JonasE99/HCP-Bridge/hardware/fabrication/bom.csv

Qty | References | Value | Footprint | Manufacturer part | LCSC
4 | C3 C6 C8 C9 | 100n | C_0603_1608Metric |  | C14663
1 | C10 | 1u | C_0603_1608Metric |  | C5673
3 | C4 C5 C7 | 22u 25V | C_1206_3216Metric |  | C77091
2 | C1 C2 | 2u2 100V | C_1206_3216Metric |  | C170101
5 | D2 D3 D4 D5 D6 | DSS16 | D_SOD-123 | DSS16 (60 V, 1 A) | C7467023
1 | D8 | SM712 | SOT-23 | Semtech SM712.TCT | C12067
1 | D1 | SMAJ33CA | D_SMA | SMAJ33CA (bidirectional) | C115251
1 | D10 | USBLC6-2SC6 | SOT-23-6 | ST USBLC6-2SC6 | C7519
1 | D9 | blue | LED_0603_1608Metric | KT-0603B | C2288
1 | D7 | green | LED_0603_1608Metric | KT-0603G | C12624
1 | F1 | 200mA | Fuse_1206_3216Metric | BSMD1206-020-48V | C49328459
1 | JP3 | 120R | SolderJumper-2_P1.3mm_Open_RoundedPad1.0x1.5mm
1 | JP1 | A select | SolderJumper-3_P1.3mm_Bridged12_RoundedPad1.0x1.5mm
1 | JP2 | B select | SolderJumper-3_P1.3mm_Bridged12_RoundedPad1.0x1.5mm
1 | J1 | RJ12 HCP bus | RJ12_Molex_95501-2661_Horizontal | Molex 95501-2661 | C240856
1 | J2 | USB-C | USB_C_Receptacle_HRO_TYPE-C-31-M-12 | HRO TYPE-C-31-M-12 | C165948
1 | L1 | 22uH | L_Sunlord_SWPA5040S | Bourns SRN5040TA-220M (Isat 1.62 A) | C2046438
1 | R1 | 100k | R_0603_1608Metric | 0603WAF1003T5E | C25803
2 | R5 R6 | 10R | R_0603_1608Metric |  | C22859
4 | R10 R11 R12 R13 | 10k | R_0603_1608Metric | Yageo RC0603FR-0710KL | C98220
1 | R9 | 120R | R_0603_1608Metric |  | C22787
2 | R4 R14 | 1k | R_0603_1608Metric | 0603WAF1001T5E | C21190
1 | R3 | 22k1 1% | R_0603_1608Metric |  | C137768
2 | R7 R8 | 4k7 | R_0603_1608Metric | 0603WAF4701T5E | C23162
2 | R15 R16 | 5k1 | R_0603_1608Metric | 0603WAF5101T5E | C23186
1 | R2 | 69k8 1% | R_0603_1608Metric |  | C23098
1 | SW2 | BOOT | SW_Push_1P1T_XKB_TS-1187A | XKB TS-1187A-B-A-B | C318884
1 | SW1 | RESET | SW_Push_1P1T_XKB_TS-1187A | XKB TS-1187A-B-A-B | C318884
1 | TP2 | ESP_RXD0 | TestPoint_Pad_D1.5mm
1 | TP1 | ESP_TXD0 | TestPoint_Pad_D1.5mm
1 | TP3 | GND | TestPoint_Pad_D1.5mm
1 | U3 | ESP32-S3-WROOM-1-N8R2 | ESP32-S3-WROOM-1 | Espressif ESP32-S3-WROOM-1-N8R2 | C2913204
1 | U1 | LMR51610XDBVR | SOT-23-6 | TI LMR51610XDBVR | C20539658
1 | U2 | THVD1406DR | SOIC-8_3.9x4.9mm_P1.27mm | TI THVD1406DR | C5215918
