JonasE99/HCP-Bridge/hardware/fabrication/schematic.pdf

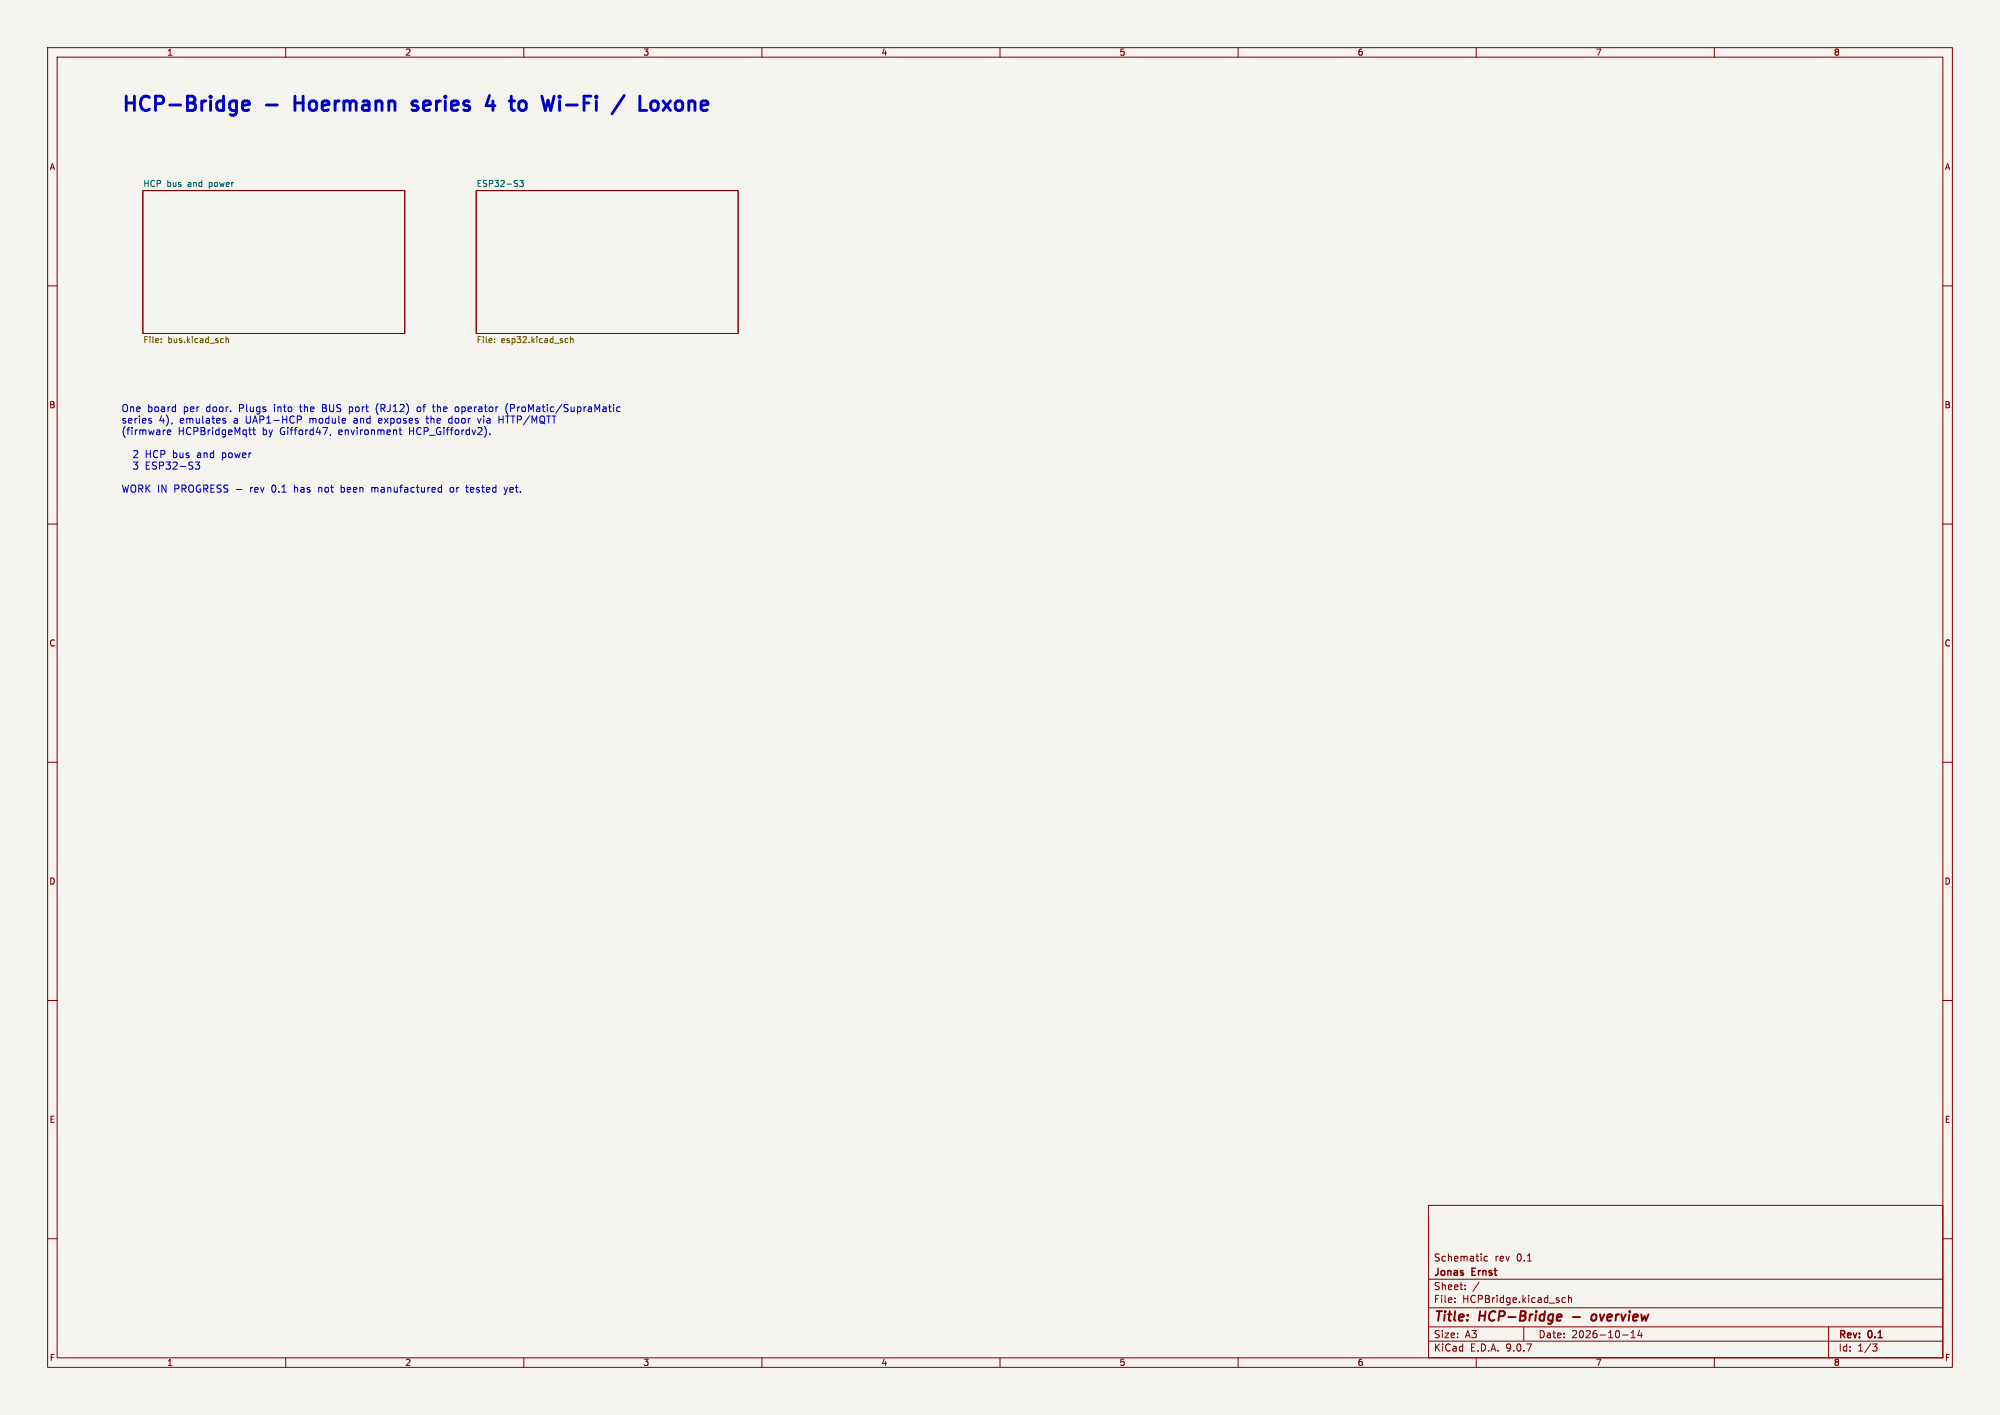
[picture p2: page 1]

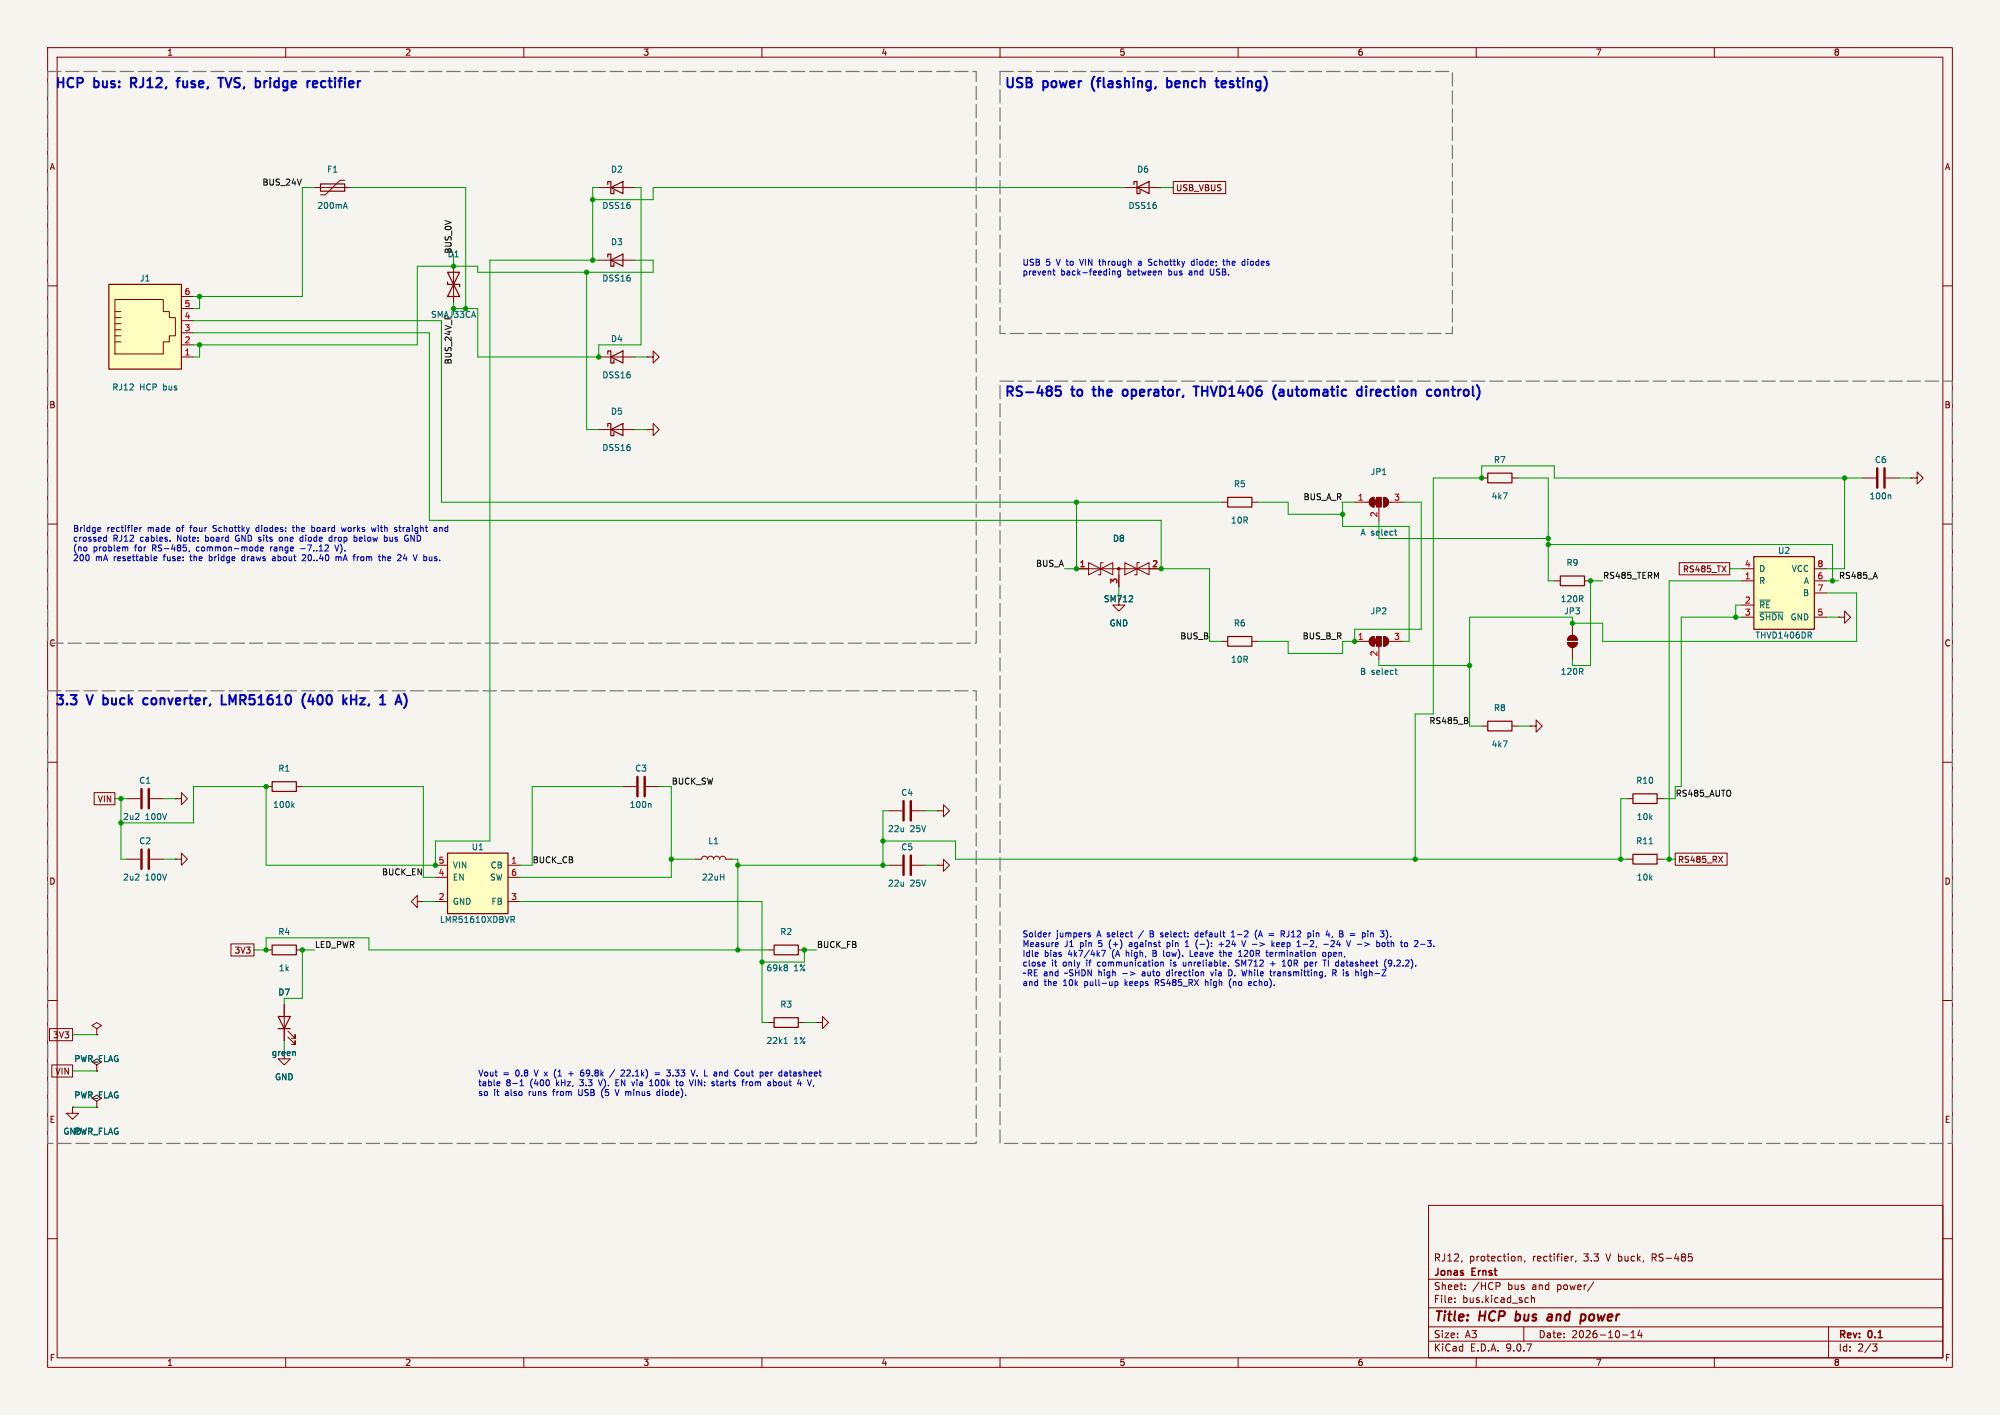
[picture p3: page 2]

crossed RJ12 cables. Note: board GND sits one diode drop below bus GND

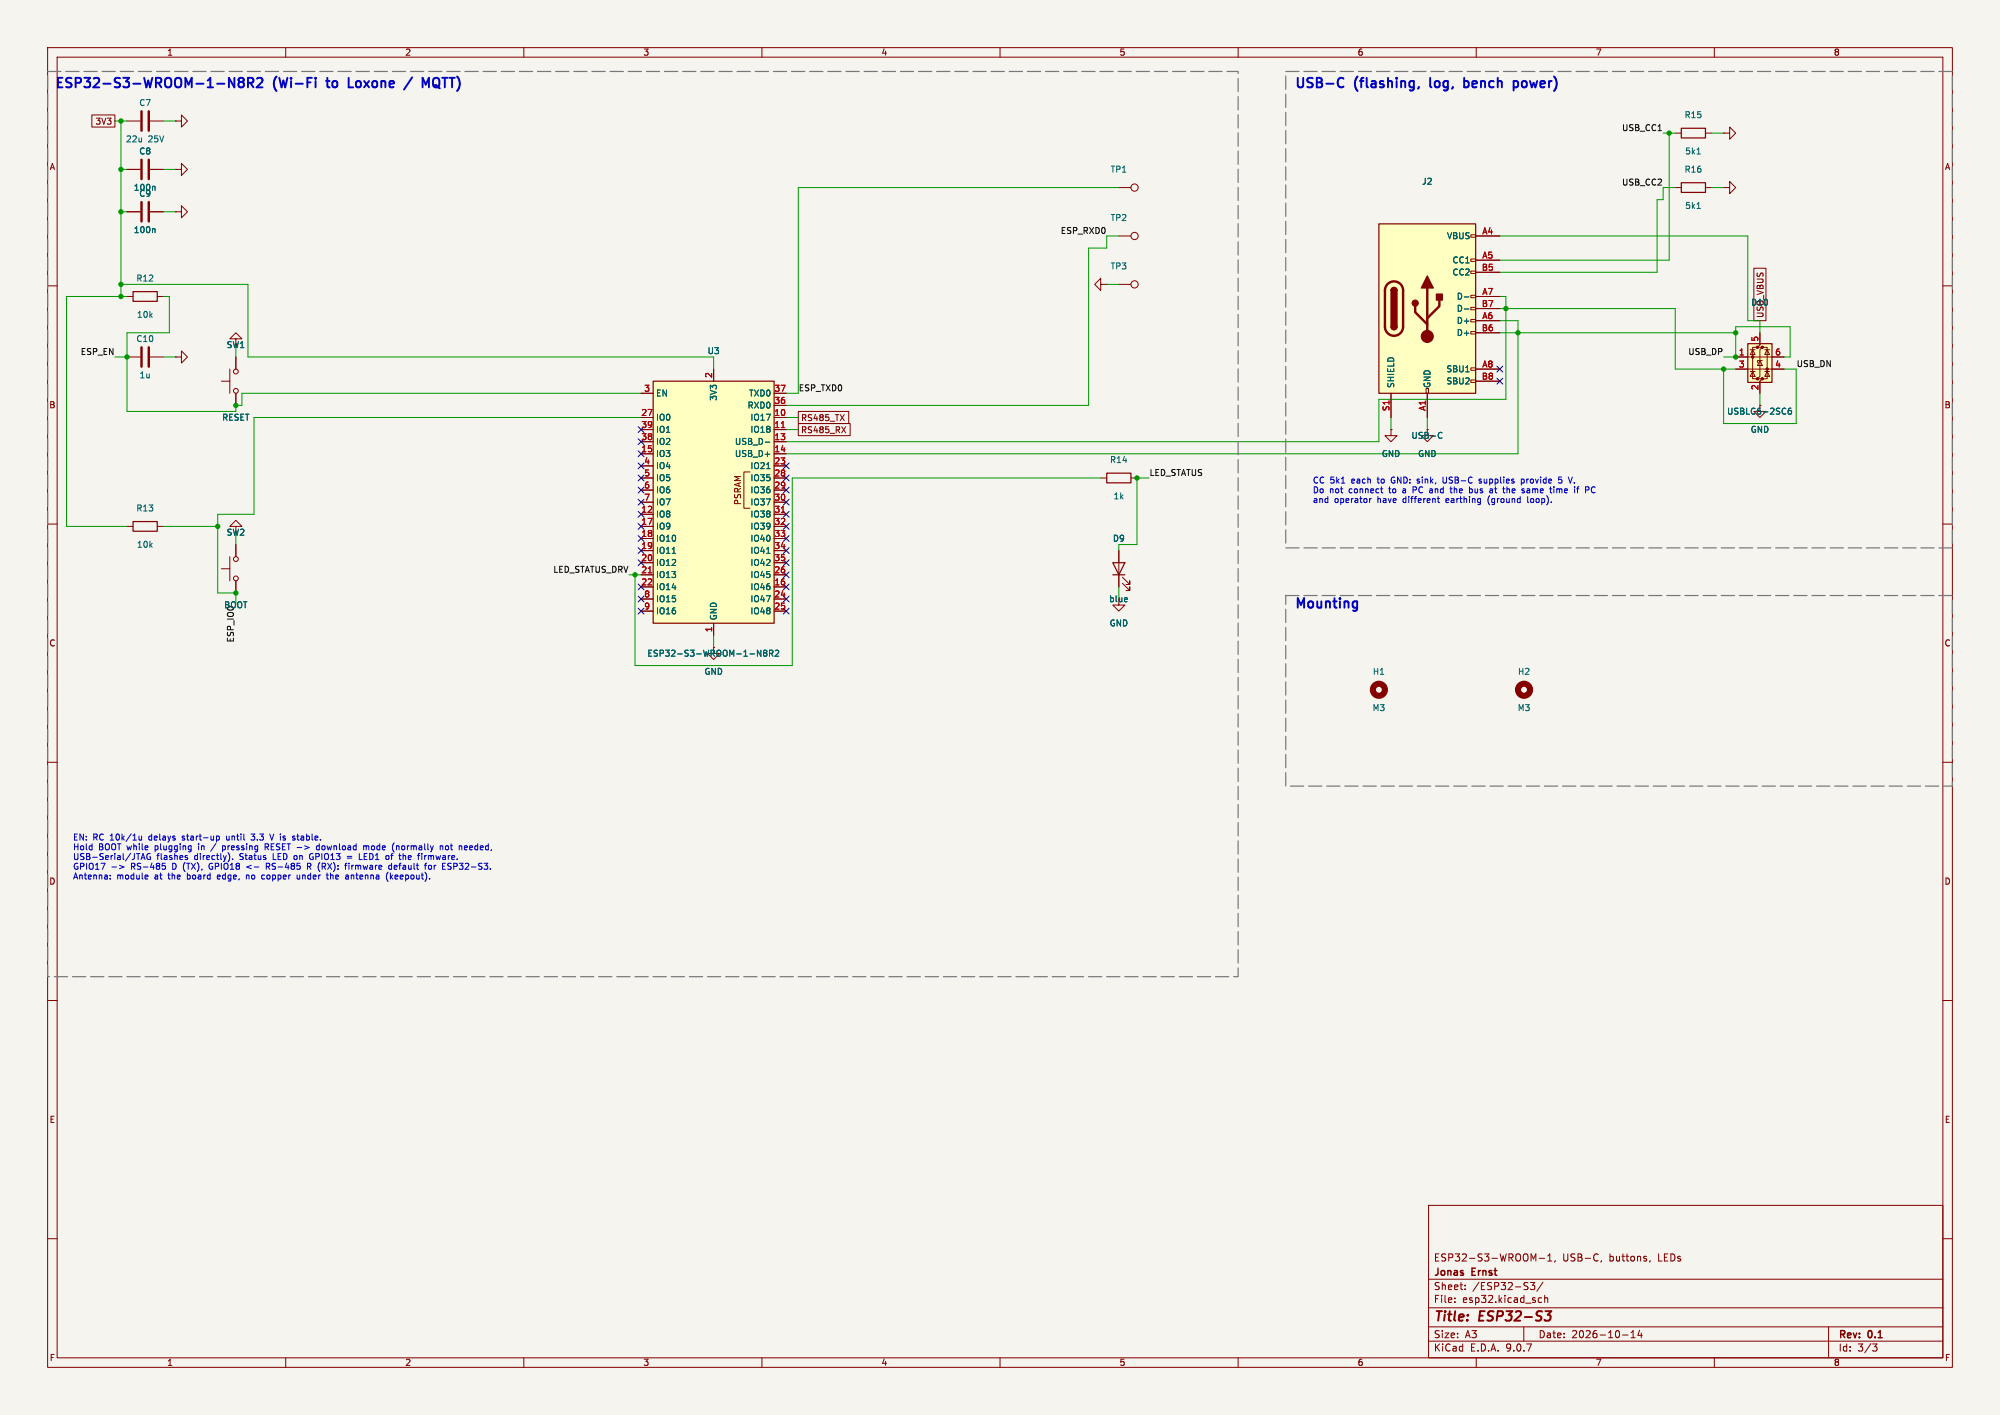
[picture p4: page 3]

blue GND GND PSRAM
