JonasE99/HCP-Bridge/hardware/fabrication/assembly.pdf

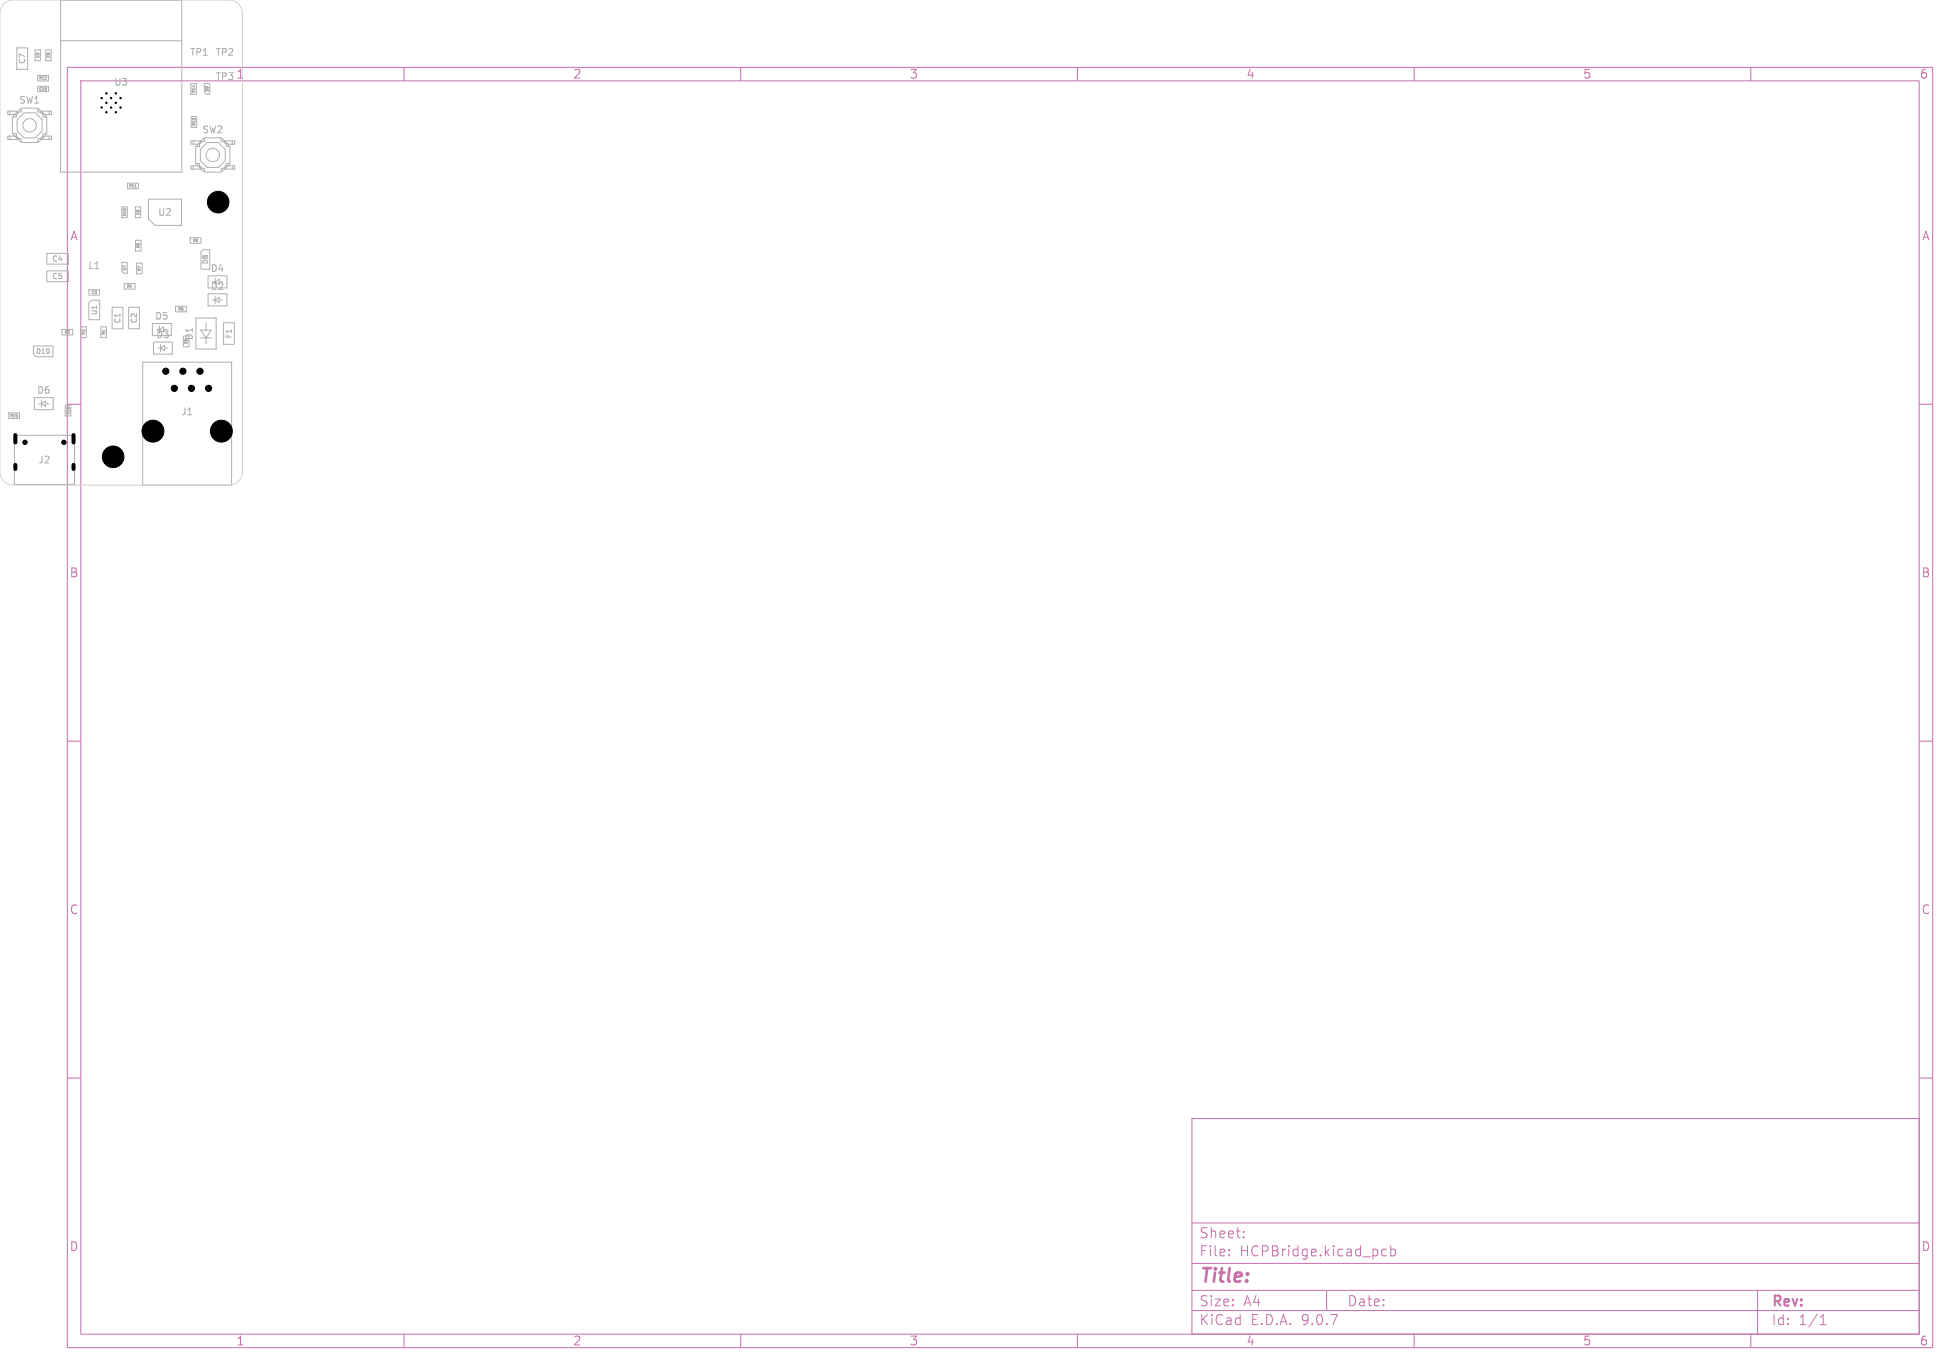
[picture p5: page 1]
