JonasE99/HCP-Bridge/hardware/fabrication/bottom.pdf

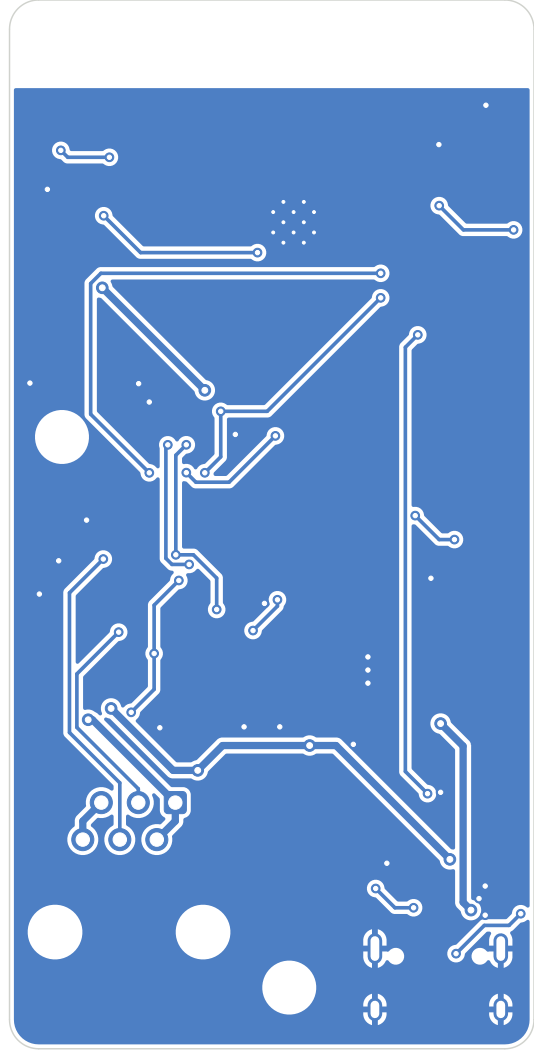
[picture p6: page 1]
