JonasE99/HCP-Bridge/hardware/fabrication/top.pdf

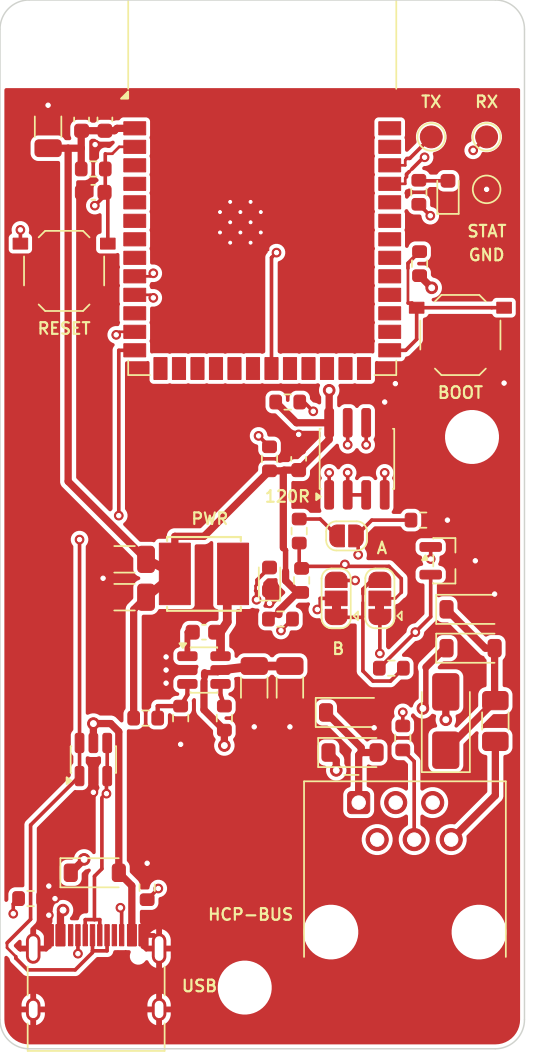
[picture p7: page 1]
