JonasE99/HCP-Bridge/hardware/kicad/HCPBridge.kicad_pcb

## KiCad design hardware/kicad/HCPBridge.kicad_pcb (2026-10-14)

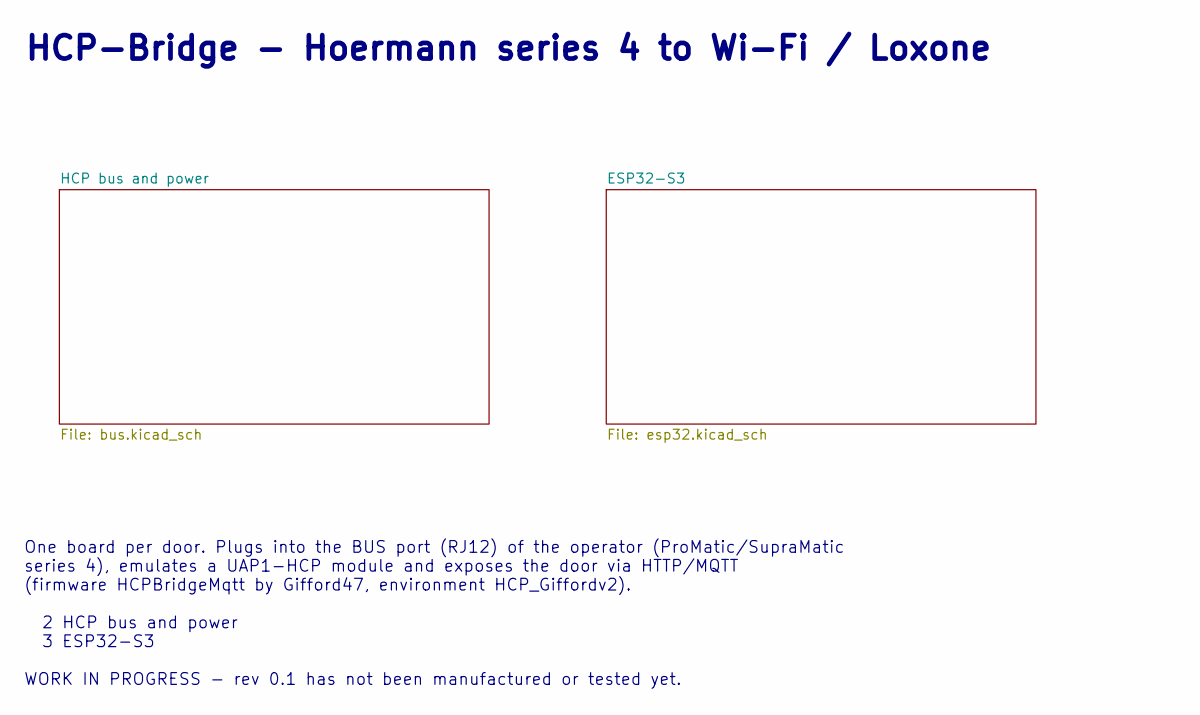
[picture p8: schematic HCPBridge.kicad_sch, HCP-Bridge - overview]

Notes on the sheet:
HCP-Bridge - Hoermann series 4 to Wi-Fi / Loxone
One board per door. Plugs into the BUS port (RJ12) of the operator (ProMatic/SupraMatic series 4), emulates a UAP1-HCP module and exposes the door via HTTP/MQTT (firmware HCPBridgeMqtt by Gifford47, environment HCP_Giffordv2). 2 HCP bus and power 3 ESP32-S3 WORK IN PROGRESS - rev 0.1 has not been m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

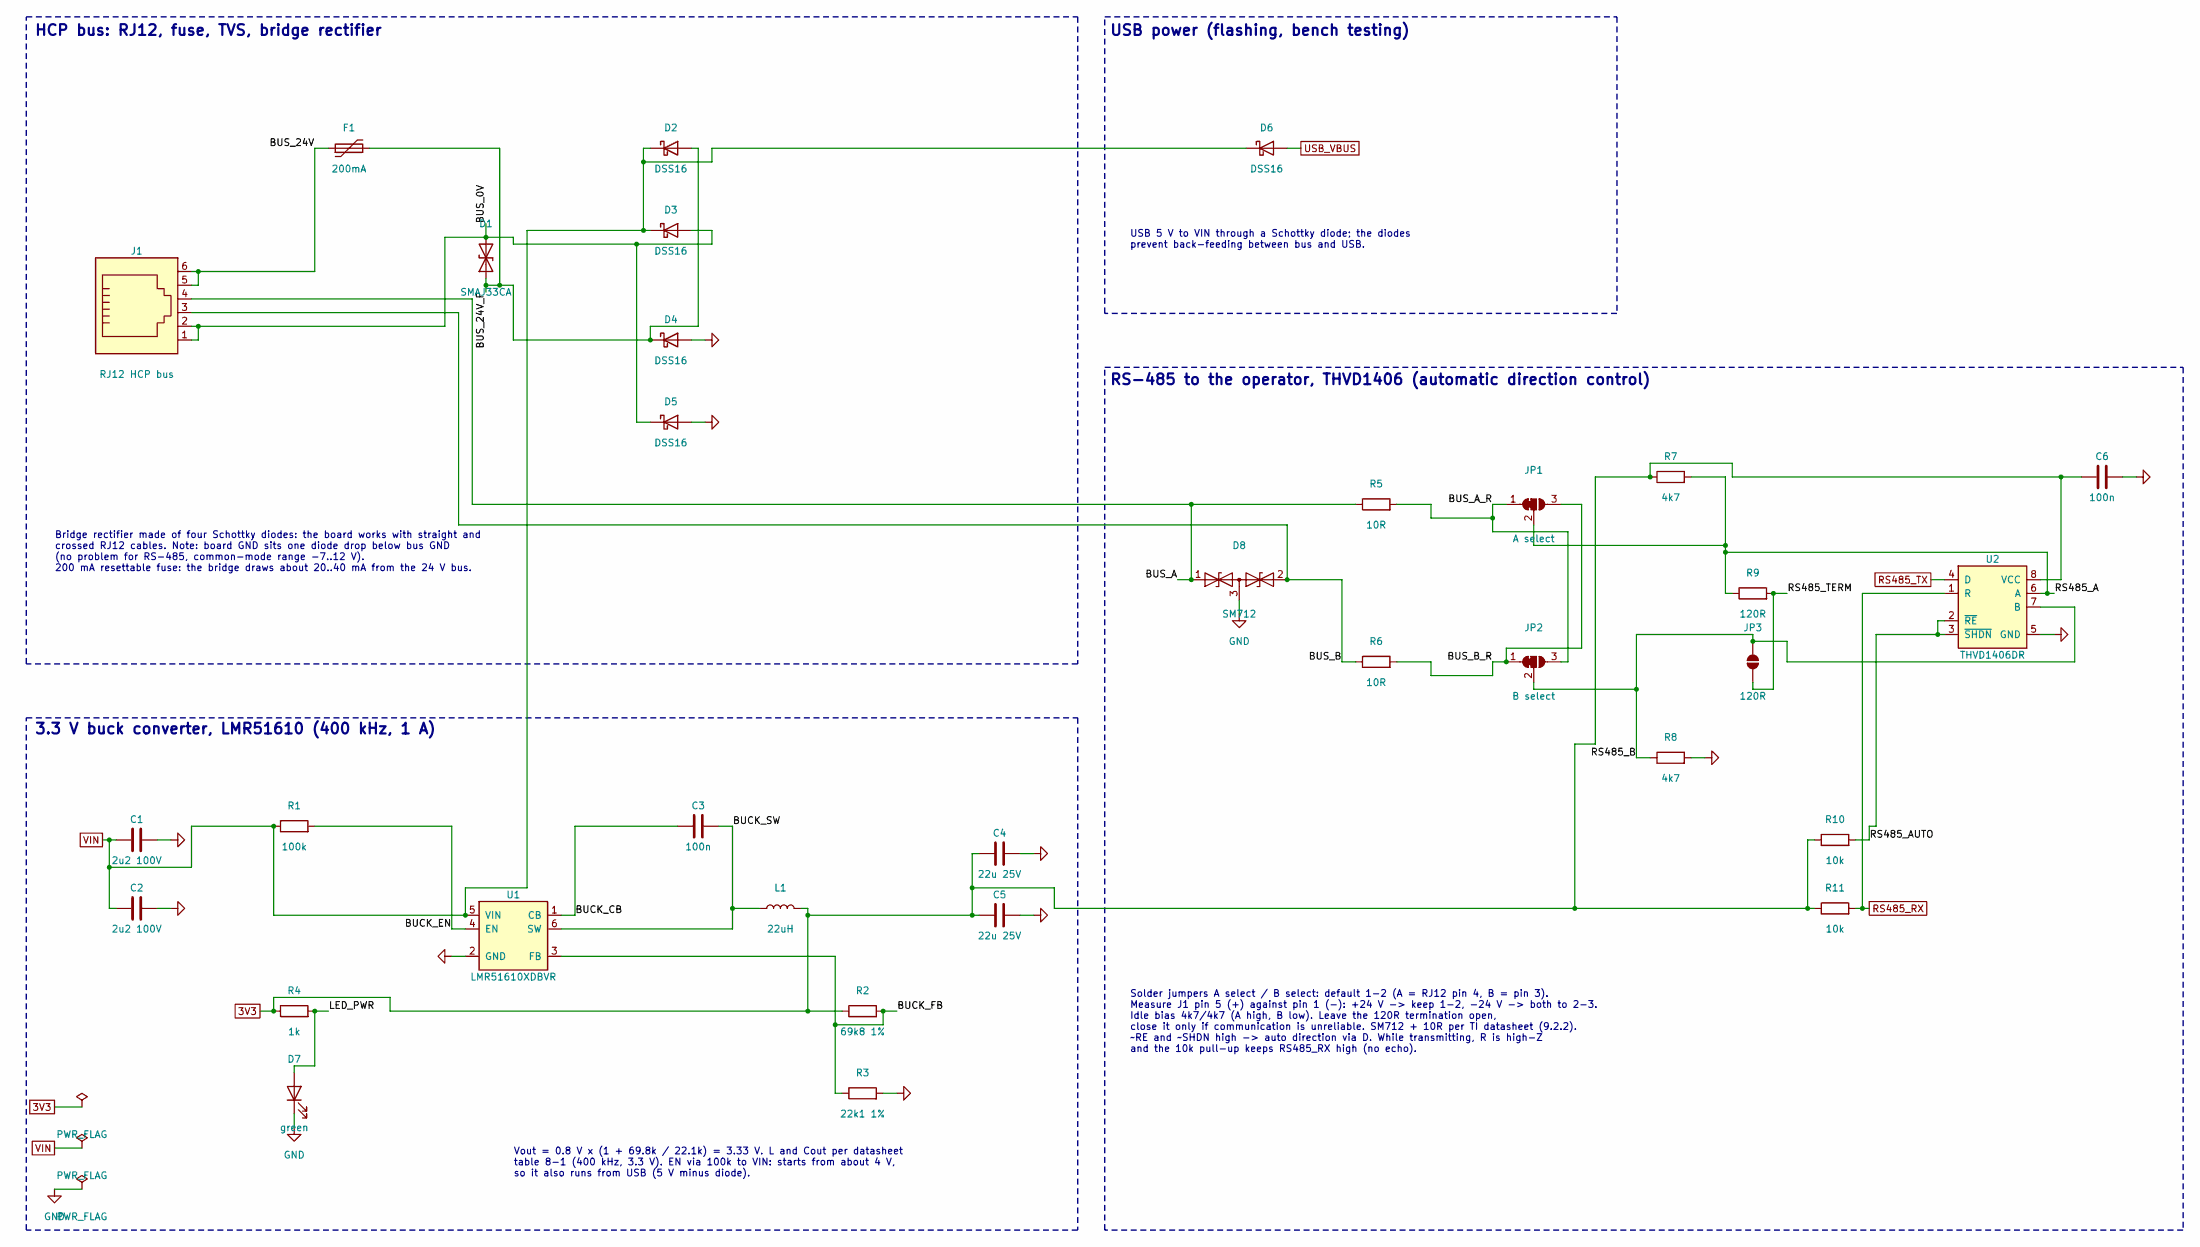
[picture p9: schematic bus.kicad_sch, HCP bus and power]

Parts:
C1, C2: 2u2 100V; C_1206_3216Metric; LCSC C170101
C3, C6: 100n; C_0603_1608Metric; LCSC C14663
C4, C5: 22u 25V; C_1206_3216Metric; LCSC C77091
D1: SMAJ33CA; D_SMA; MPN SMAJ33CA (bidirectional); LCSC C115251
D2, D3, D4, D5, D6: DSS16; D_SOD-123; MPN DSS16 (60 V, 1 A); LCSC C7467023
D7: green; LED_0603_1608Metric; MPN KT-0603G; LCSC C12624
D8: SM712; SOT-23; MPN Semtech SM712.TCT; LCSC C12067
F1: 200mA; Fuse_1206_3216Metric; MPN BSMD1206-020-48V; LCSC C49328459
J1: RJ12 HCP bus; RJ12_Molex_95501-2661_Horizontal; MPN Molex 95501-2661; LCSC C240856
JP1: A select; SolderJumper-3_P1.3mm_Bridged12_RoundedPad1.0x1.5mm
JP2: B select; SolderJumper-3_P1.3mm_Bridged12_RoundedPad1.0x1.5mm
JP3: 120R; SolderJumper-2_P1.3mm_Open_RoundedPad1.0x1.5mm
L1: 22uH; L_Sunlord_SWPA5040S; MPN Bourns SRN5040TA-220M (Isat 1.62 A); LCSC C2046438
R1: 100k; R_0603_1608Metric; MPN 0603WAF1003T5E; LCSC C25803
R2: 69k8 1%; R_0603_1608Metric; LCSC C23098
R3: 22k1 1%; R_0603_1608Metric; LCSC C137768
R4: 1k; R_0603_1608Metric; MPN 0603WAF1001T5E; LCSC C21190
R5, R6: 10R; R_0603_1608Metric; LCSC C22859
R7, R8: 4k7; R_0603_1608Metric; MPN 0603WAF4701T5E; LCSC C23162
R9: 120R; R_0603_1608Metric; LCSC C22787
R10, R11: 10k; R_0603_1608Metric; MPN Yageo RC0603FR-0710KL; LCSC C98220
U1: LMR51610XDBVR; SOT-23-6; MPN TI LMR51610XDBVR; LCSC C20539658
U2: THVD1406DR; SOIC-8_3.9x4.9mm_P1.27mm; MPN TI THVD1406DR; LCSC C5215918

Connections:
3V3: C4.1, C5.1, C6.1, L1.2, R2.1, R4.1, R7.1, R10.1, R11.1, U2.8 (VCC); also elsewhere on the board
BUCK_CB: C3.1, U1.1 (CB)
BUCK_EN: R1.2, U1.4 (EN)
BUCK_FB: R2.2, R3.1, U1.3 (FB)
BUCK_SW: C3.2, L1.1, U1.6 (SW)
BUS_0V: D1.2 (A2), D3.2 (A), D5.1 (K), J1.1, J1.2
BUS_24V: F1.1, J1.5, J1.6
BUS_24V_F: D1.1 (A1), D2.2 (A), D4.1 (K), F1.2
BUS_A: D8.1 (A1), J1.4, R5.1
BUS_A_R: JP1.1 (A), JP2.3 (B), R5.2
BUS_B: D8.2 (A2), J1.3, R6.1
BUS_B_R: JP1.3 (B), JP2.1 (A), R6.2
GND: C1.2, C2.2, C4.2, C5.2, C6.2, D4.2 (A), D5.2 (A), D7.1 (K), D8.3 (common), R3.2, R8.2, U1.2 (GND), U2.5 (GND); also elsewhere on the board
LED_PWR: D7.2 (A), R4.2
RS485_A: JP1.2 (C), R7.2, R9.1, U2.6 (A)
RS485_AUTO: R10.2, U2.2 (~RE), U2.3 (~SHDN)
RS485_B: JP2.2 (C), JP3.2 (B), R8.1, U2.7 (B)
RS485_RX: R11.2, U2.1 (R); also elsewhere on the board
RS485_TERM: JP3.1 (A), R9.2
RS485_TX: U2.4 (D); also elsewhere on the board
USB_VBUS: D6.2 (A); also elsewhere on the board
VIN: C1.1, C2.1, D2.1 (K), D3.1 (K), D6.1 (K), R1.1, U1.5 (VIN)

Notes on the sheet:
HCP bus: RJ12, fuse, TVS, bridge rectifier
Bridge rectifier made of four Schottky diodes: the board works with straight and crossed RJ12 cables. Note: board GND sits one diode drop below bus GND (no problem for RS-485, common-mode range -7..12 V). 200 mA resettable fuse: the bridge draws about 20..40 mA from the 24 V bus.
USB power (flashing, bench testing)
USB 5 V to VIN through a Schottky diode; the diodes prevent back-feeding between bus and USB.
3.3 V buck converter, LMR51610 (400 kHz, 1 A)
Vout = 0.8 V x (1 + 69.8k / 22.1k) = 3.33 V. L and Cout per datasheet table 8-1 (400 kHz, 3.3 V). EN via 100k to VIN: starts from about 4 V, so it also runs from USB (5 V minus diode).
RS-485 to the operator, THVD1406 (automatic direction control)
Solder jumpers A select / B select: default 1-2 (A = RJ12 pin 4, B = pin 3). Measure J1 pin 5 (+) against pin 1 (-): +24 V -> keep 1-2, -24 V -> both to 2-3. Idle bias 4k7/4k7 (A high, B low). Leave the 120R termination open, close it only if communication is unreliable. SM712 + 10R per TI datashee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

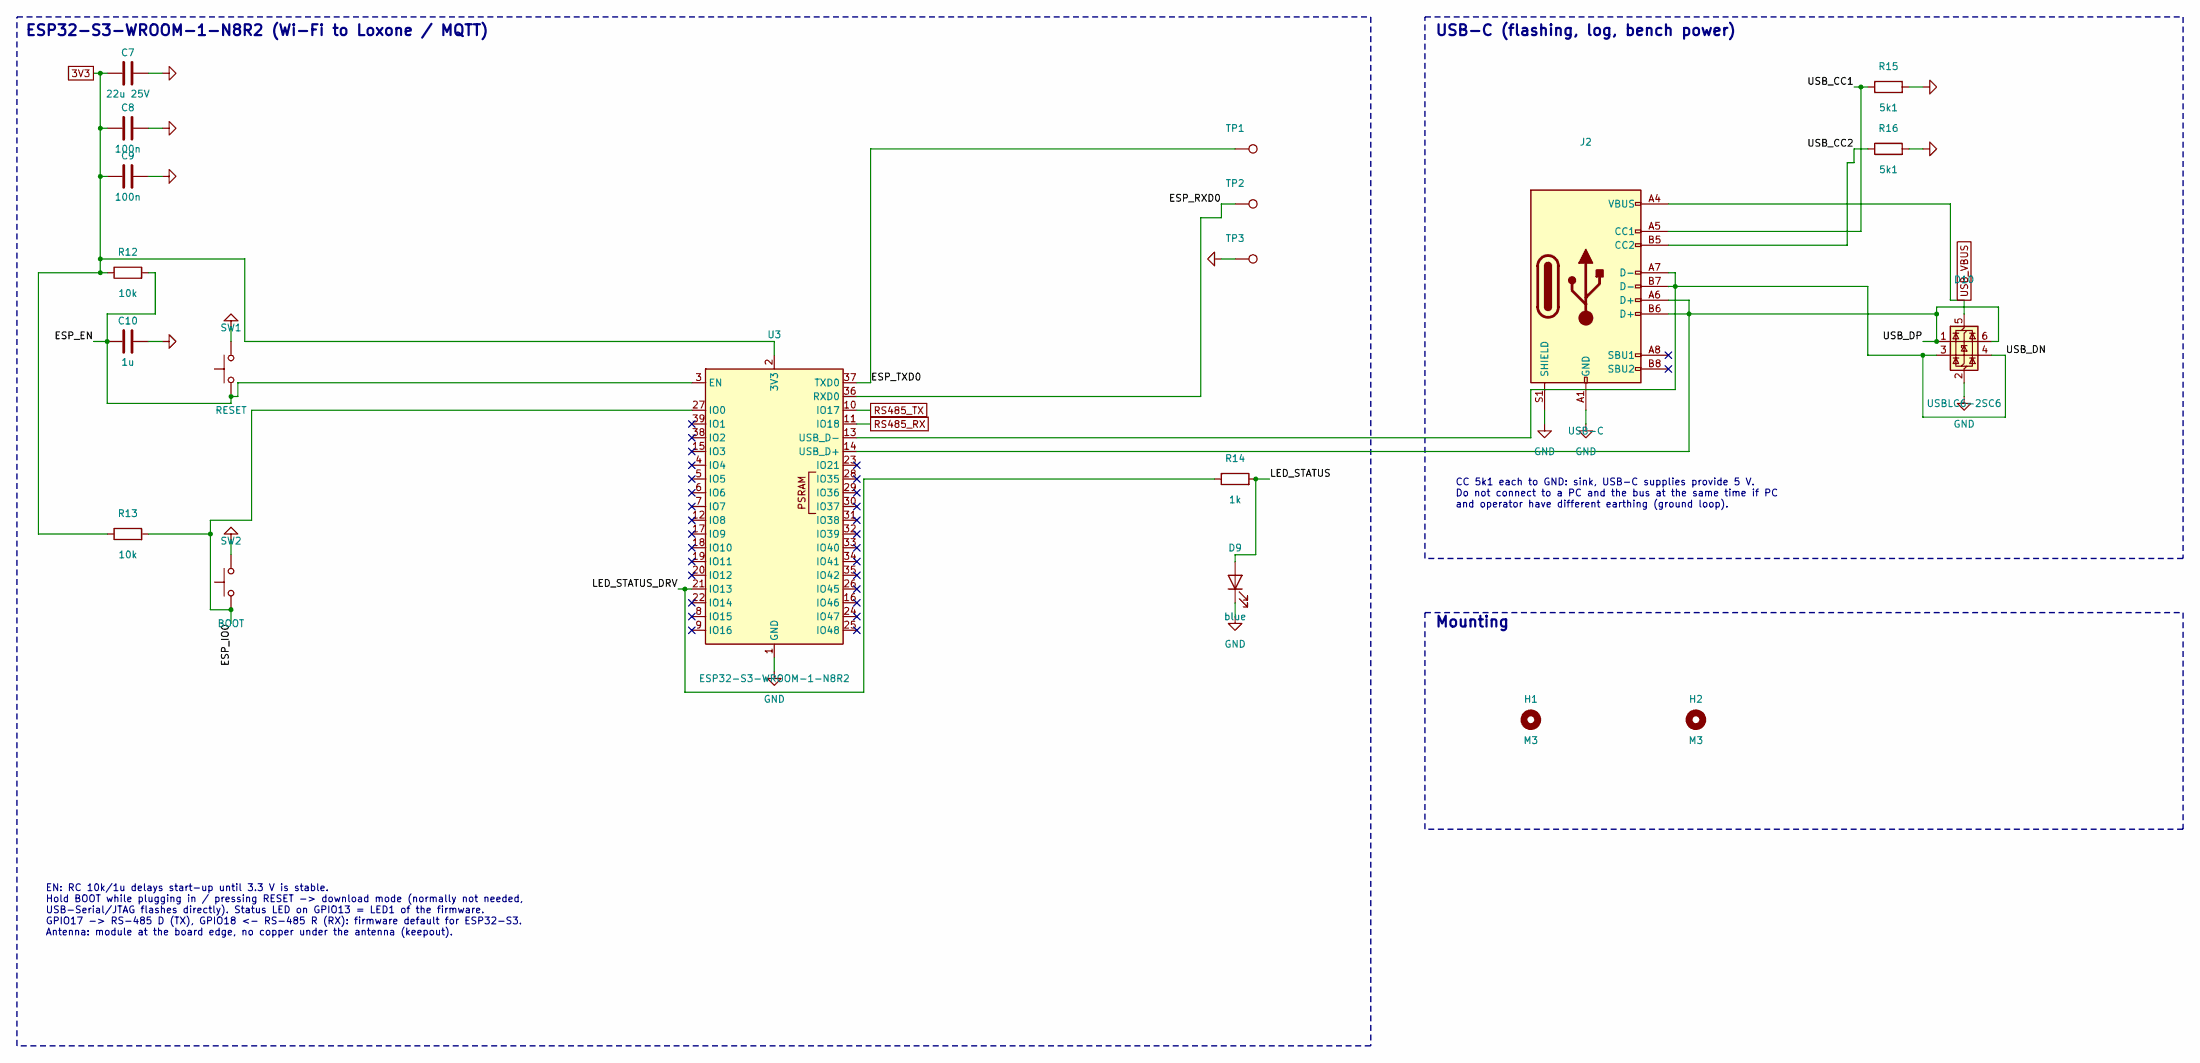
[picture p10: schematic esp32.kicad_sch, ESP32-S3]

Parts:
C7: 22u 25V; C_1206_3216Metric; LCSC C77091
C8, C9: 100n; C_0603_1608Metric; LCSC C14663
C10: 1u; C_0603_1608Metric; LCSC C5673
D9: blue; LED_0603_1608Metric; MPN KT-0603B; LCSC C2288
D10: USBLC6-2SC6; SOT-23-6; MPN ST USBLC6-2SC6; LCSC C7519
H1, H2: M3; MountingHole_3.2mm_M3
J2: USB-C; USB_C_Receptacle_HRO_TYPE-C-31-M-12; MPN HRO TYPE-C-31-M-12; LCSC C165948
R12, R13: 10k; R_0603_1608Metric; MPN Yageo RC0603FR-0710KL; LCSC C98220
R14: 1k; R_0603_1608Metric; MPN 0603WAF1001T5E; LCSC C21190
R15, R16: 5k1; R_0603_1608Metric; MPN 0603WAF5101T5E; LCSC C23186
SW1: RESET; SW_Push_1P1T_XKB_TS-1187A; MPN XKB TS-1187A-B-A-B; LCSC C318884
SW2: BOOT; SW_Push_1P1T_XKB_TS-1187A; MPN XKB TS-1187A-B-A-B; LCSC C318884
TP1: ESP_TXD0; TestPoint_Pad_D1.5mm
TP2: ESP_RXD0; TestPoint_Pad_D1.5mm
TP3: GND; TestPoint_Pad_D1.5mm
U3: ESP32-S3-WROOM-1-N8R2; ESP32-S3-WROOM-1; MPN Espressif ESP32-S3-WROOM-1-N8R2; LCSC C2913204

Connections:
3V3: C7.1, C8.1, C9.1, R12.1, R13.1, U3.2 (3V3); also elsewhere on the board
ESP_EN: C10.1, R12.2, SW1.1, U3.3 (EN)
ESP_IO0: R13.2, SW2.1, U3.27 (IO0)
ESP_RXD0: TP2.1, U3.36 (RXD0)
ESP_TXD0: TP1.1, U3.37 (TXD0)
GND: C7.2, C8.2, C9.2, C10.2, D9.1 (K), D10.2 (GND), J2.A1 (GND), J2.A12 (GND), J2.B1 (GND), J2.B12 (GND), J2.S1 (SHIELD), R15.2, R16.2, SW1.2, SW2.2, TP3.1, U3.1 (GND), U3.40 (GND), U3.41 (GND); also elsewhere on the board
LED_STATUS: D9.2 (A), R14.2
LED_STATUS_DRV: R14.1, U3.21 (IO13)
RS485_RX: U3.11 (IO18); also elsewhere on the board
RS485_TX: U3.10 (IO17); also elsewhere on the board
USB_CC1: J2.A5 (CC1), R15.1
USB_CC2: J2.B5 (CC2), R16.1
USB_DN: D10.3 (I/O2), D10.4 (I/O2), J2.A7 (D-), J2.B7 (D-), U3.13 (USB_D-)
USB_DP: D10.1 (I/O1), D10.6 (I/O1), J2.A6 (D+), J2.B6 (D+), U3.14 (USB_D+)
USB_VBUS: D10.5 (VBUS), J2.A4 (VBUS), J2.A9 (VBUS), J2.B4 (VBUS), J2.B9 (VBUS); also elsewhere on the board

Notes on the sheet:
ESP32-S3-WROOM-1-N8R2 (Wi-Fi to Loxone / MQTT)
EN: RC 10k/1u delays start-up until 3.3 V is stable. Hold BOOT while plugging in / pressing RESET -> download mode (normally not needed, USB-Serial/JTAG flashes directly). Status LED on GPIO13 = LED1 of the firmware. GPIO17 -> RS-485 D (TX), GPIO18 <- RS-485 R (RX): firmware default for ESP32-S3. A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
USB-C (flashing, log, bench power)
CC 5k1 each to GND: sink, USB-C supplies provide 5 V. Do not connect to a PC and the bus at the same time if PC and operator have different earthing (ground loop).
Mounting

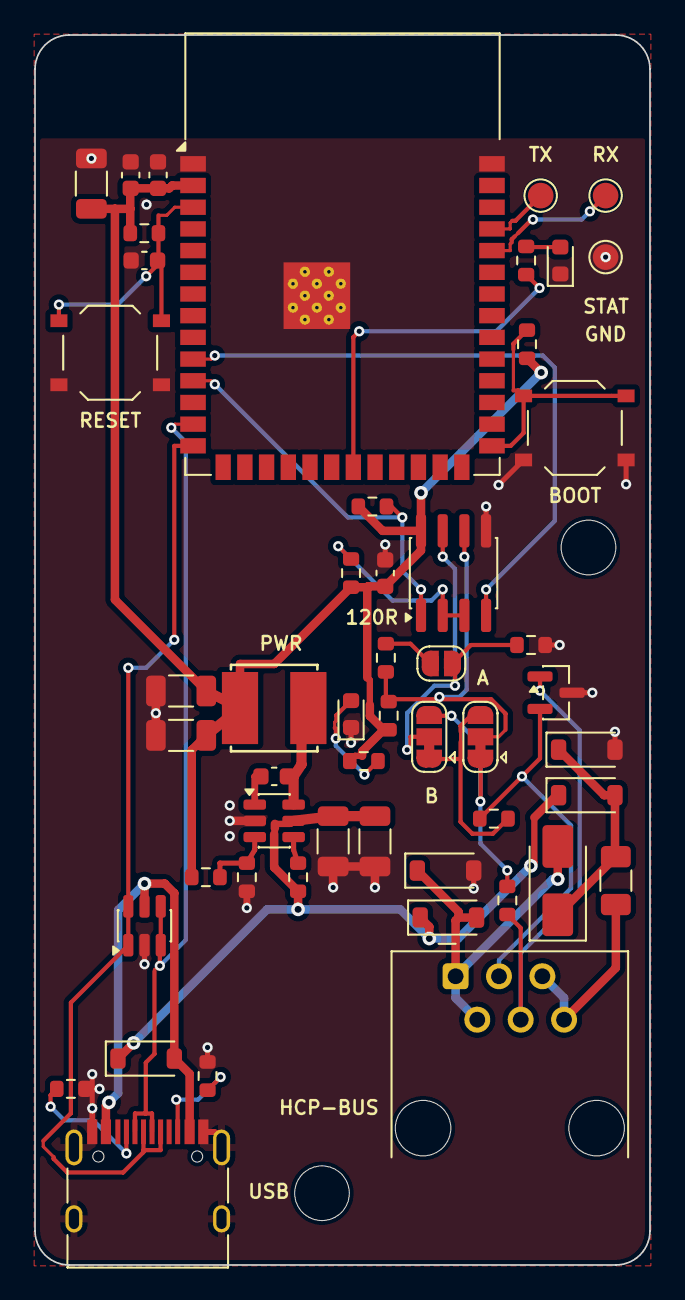
[picture p11: board HCPBridge.kicad_pcb from above]

Board: 2 copper layers, 36.0 x 72.0 mm, 53 parts (0 on the bottom side), 32 nets.
